TimothyHadfield/polar-cnc-plotter/chat.md

# Polar CNC Plotter: chat log (for Claude)

_One entry per session, newest at the bottom, capped at 60 KB. Older entries go to
`docs/archive/chat-archive.md`. The current state is in `progress.md`. Sessions before 2026-10-25
are only in git history and `docs/archive/progress-2026-10-27.md`._

## 2026-10-25..27 · build guide realism, carriage pocket, upgrade parts, motor debugging
- **Asked:** "make everything look like it does in real life" + tap-to-select; belt/idler fixes;
  better idler and platter-drive ideas; "change my pen holder carraige 3D print so it can have an
  indent nicely for the new wire stepper motor"; "make the arduino and shield V3 and motor drivers
  ... look nearly identical"; "send sub-agents to work on the other tasks"; troubleshooting.
- **Decided:** direct-drive platter + M3 idler recommended and built as STLs (Tim's go); red A4988
  on Z; binned 5 shorted drivers.
- **Built:** realistic build guide + tap card; X belt/idler model; carriage plate stage pocket
  (3fed47d); electronics model (9512a75); builders: platter_hub + motor_stand (ab39a36), motor_plate
  recess, pulley_m3, idler_washer, big_pulley_gt2, paper_ring (31ab319).
- **Verified how:** phone-view WebKit 393 px + 1440 px screenshots; OpenSCAD renders; trimesh
  watertight + measured sizes (GT2 OD 37.69 mm, 60 teeth); GRBL replies on COM3 (moves completed).
- **Machine:** dead/shorted drivers found by 5V-GND Ω (tripped USB fuse); coil pairs fixed on both
  NEMAs; X works; platter motor works on the X header; Y channel sends nothing; Z untested.
- **Open:** ask Tim whether the last test had X/Y drivers swapped; driver-vs-slot for Y (A-slot
  clone if the socket is dead); Z wiring; Calibrate; Tim to caliper the stage + shaft and check
  platter clearance; magnets vs tape for paper_ring (money = Tim).

## 2026-10-28 · motor troubleshooting, plotter being disassembled
- **Asked:** why the platter went jerky again; "Is anything ruined?" (pulled the Y plug powered);
  how to free the epoxied platter; "okay back to the troubleshooting".
- **Decided:** both NEMA plugs at 1-3-2-4; Y channel dead (carriage works on X, not on Y);
  platter jerk is electrical (spins freely by hand), suspect Tim's extension/plug; bench-test plan.
- **Built:** nothing (notes only).
- **Verified how:** Tim's meter and observations only; no COM port present today (USB unplugged).
  Tests not rerun (no code change since 10-27: 96/96).
- **Open:** Tim redesigned parts (unknown what) and is disassembling; bench test platter motor
  direct on X; driver-board swap X<->Y; Z; Calibrate.

## 2026-11-10..11 · bench debug to all three axes working
- **Asked:** "let's keep working on it" (motors before the full rebuild); for-sure driver test;
  which drivers to buy; returns.
- **Decided:** Tim drives the jogs, Claude advises; same Teyleten TMC2209 5-pack (Tim bought it).
- **Found:** Y and Z black drivers dead (one-variable swap in the proven X slot); most "jerky" =
  half-seated plugs/drivers or split coil pairs; new pen stage coils were 1-3 / 2-4 (middle swap
  fixed it, verified with Claude's Z jogs on COM3); platter plug middle wire loose.
- **Verified how:** Tim's observations + GRBL replies on COM3 (settings factory, Z jogs "ok").
- **Open:** rebuild; `$102` for the stage; Calibrate; Claude's earlier "smallest step" advice was
  wrong (0.1 mm jog ≈ invisible with factory `$102`).

## 2026-11-12 · fasteners, no fit test, then a full engineering review
- **Asked:** which screws/nuts and where to buy (Ace, Orem); use his M3 × 8 pan heads on the
  collar; "I'm not gonna do a test print"; after switching model: "let's do all of that. I have the
  base plate design actively printing right now but that's it."
- **Decided:** base untouched (printing); stands, wheel, collar free to change; fit test dropped
  from plate 1; printed washers instead of buying M3 × 6.
- **Built:** stand groove relief + foot clearance, steeper collar taper, collar gauge, motor
  washers, wheel 2 mm over the cage (lift +1), guide wording fixes (stands from the back, supports
  setting, gauge, 1.0 V, GRBL speeds), sim travel 93, plotter-v2.glb rebuilt, plates 1/3/4.
- **Verified how:** OpenSCAD intersections (seated, sliding in, stop, lift, travel 93/94, screw
  sweep, spinning envelope vs everything fixed: all as expected); headless Bambu Studio slices of
  all 5 plates with Tim's X1C presets; 101/101 node tests; phone-view 393 px + 1440 px of
  build.html?v=2 and sim.html?v=2 on localhost.
- **Open:** pen clip for the new slider needs Tim's measurements; nothing printed from the changed
  parts yet. Base supports: Tim "did add supports"; Bambu's default leaves "On build plate only"
  unticked (stock preset checked, no user preset), so the cage roof should be supported.

## 2026-11-12 (later) · Draw tool
- **Asked:** "for the plotter app, could you make a feature where you can draw your own design
  yourself on the plate as a submission for the drawing?"
- **Decided (Claude, flagged to Tim):** a Draw button beside Text/Pattern, same tool-panel pattern;
  drawing lands exactly where drawn (no auto-fit); Undo also undoes Clear; kept across reloads.
- **Built:** `js/sketch.js`, `strokes.radius` in `fitFrame`, `layout()` split out of `prepare`,
  place.js steps aside while drawing, `tests/sketch.test.mjs` (10 tests).
- **Verified how:** tests seen failing first (stretch-to-fit, no smoothing), then 111/111; headless
  WebKit at 393 px and 1440 px: drew a face with mouse drags + taps, start point within 1 px of the
  pointer, undo/clear/undo, Done -> "4 strokes", move 20 mm then Draw again (stays put), touch tap,
  reload keeps it; no console errors, no page scroll.
- **Open:** Tim's finger on his iPhone; laptop button row wraps.

## 2026-11-13 · Simulate the drawing
- **Asked:** "allow the user to simulate the drawing aswell."
- **Found:** the Draw commit had broken sim.html (app.js runs there too; no `#openDraw` ->
  exception at start-up, seen live with phone-view). Fixed in the same change (see Traps).
- **Decided (Claude, flagged to Tim):** read as "watch the 3D plotter draw what I made": a Simulate
  link beside Download G-code that carries the drawing over; Draw tool also inside the simulator;
  opens V2.
- **Built:** `js/handoff.js` + `tests/handoff.test.mjs` (4 tests, seen failing with the extras
  dropped), Simulate link, Draw button/panel in sim.html, inset grows while drawing.
- **Verified how:** 115/115 tests; headless WebKit 393 px + 1440 px, local then live: sim.html
  v=1/v=2 load with no exceptions; draw face -> Done -> move -> Simulate -> same "4 strokes" in the
  simulator -> Connect -> Plot at 100× -> "Done in 1 min." -> Draw there adds a 5th stroke.
- **Open:** Tim's own try; on the phone the simulator's small plan shows Crop/Reset overlapping
  (older layout, not touched).

## 2026-11-13 (later) · collar onto the clamp-ring plate
- **Asked:** "put that necessary connector in the last plate and clamp ring print so I can easily
  skip the test print and still have all the necessary parts."
- **Decided (Claude, flagged to Tim):** moved everything from plate 1 (collar, gauge, washers), not
  only the collar, since the gauge and washers are needed too; plate 1 removed; file renamed
  `plate5_clamp_ring_and_small_parts.3mf`; plate numbers kept.
- **Verified how:** meshes compared with the committed plate 1/5 (identical); gaps on a 0.5 mm
  grid; headless Bambu Studio slice with Tim's X1C presets (33 min, 18 g, 0 supports).
- **Open:** nothing printed from it yet.
- **Brim question:** the message Tim saw is a rotating Bambu tip (hints.ini), not a warning; his
  preset is brim Auto and the slice made no brim. Nothing changed.
- **ABS question:** out of PLA; answered yes and added an ABS version of plate 5 (ring 100.4 % in
  X/Y, reasoned). Sliced headless with Bambu ABS on Textured PEI. Open: whether Tim's wheel is PLA
  (assumed), and how the hooks actually fit.

## 2026-11-13 (evening) · first assembly report
- **Asked:** printed everything but plate 5; pen ~1 inch behind the platter motor; Uno pads block
  the board's bottom pins; one base rail printed rough. "Don't change anything yet, I'll talk about
  specific dimensions in a bit."
- **Decided:** nothing built. Agreed with his fix (reprint the base, cage moved toward the rods);
  cause = the never-measured `carriage_d`. Details in progress.md (11-13 block).
- **Open:** his dimensions; a photo of the rough rail; his other base problems.

## 2026-11-13 (night) · base 2 and the stage model
- **Asked:** his diagnosis: the model's linear stage is "a large brick that pushes the pen and pen
  holder out quite a lot"; the real slider "only sticks out about 1 cm further than the rest of the
  motor". "Try to redesign both the model and the base plate so that it fixes these problems I
  stated." Mid-work: "how close are you to finishing"; "pull up the build guide artifact again"
  (opened the checklist artifact; said which reading was taken).
- **Decided (Claude, flagged to Tim):** platter motor adjustable +-10 mm front to back instead of a
  fixed stop (his inch = 25 mm vs the corrected chain's 14 mm; pen holder not final); cage centre
  20 mm back; roof kept whole (shaft slot + boss channel); rail left alone; extra file
  `plate2_base_only.3mf`.
- **Built:** stage/slider model, `pen_y` 3.0, new `motor_cage()`, pads loop removed, frame_base.stl,
  both GLBs, plate 2 files, sim centres, wire routes, guide step, checklist artifact.
- **Verified how:** OpenSCAD intersections (motor at both ends, sliding in, over-travel hits the
  ribs, spinning envelope, carriage), watertight STL, headless Bambu slice (3 h 2, 150 g, supports
  only under the cage roof), GLB centres measured at y 3.00, 115/115 tests, headless WebKit 393 px
  + 1440 px of build.html and sim.html (v1 + v2), no exceptions.
- **Open:** the print itself; his "other problems"; the rail photo; pen clip for the new slider.

## 2026-11-13 (late) · calibration by Stop button, pen holder, cutting circles
- **Asked:** "I have the entire thing built perfectly and I'm ready to start working on the
  calibration. Could you make the calibration system more intuitive? For example, have the plate
  move slowly in a circle until the user says stop at 360 degrees ... Or have the linear motor
  slowly move down until the user clicks stop ... For the X axis maybe Calibrate it so that it
  knows where the edges of the plate are, and then it can calculate where the center is itself?"
  Also: the missing pen-holder piece ("the longer flat part with round holders on the end"), and
  "a pdf that has circles on it with the same size as the plate" for the paper and the rubber.
  Earlier: what the printed bar with an indent is (the collar gauge).
- **Decided (Claude, flagged to Tim):** the pen cannot reach both plate edges (93 mm one side, 78
  the other), so the center comes from a circle the pen draws and then crosses; that circle,
  measured with a ruler, also gives `$100` (the old 20 mm rail test is gone). Slow speeds are set in
  motor steps per second. `$101` rounds to the exact direct-drive value within 2 %. Pen heights are
  saved as up 0 / down -lift with `G92 Z0` at the up height. Holder neck narrowed 18 -> 13.6 mm so
  his printed clip (14 mm opening) goes over it. Paper circle 196 mm, pad 200 mm.
- **Built:** `js/calibrate.js` rewritten (steps 2-5), `grbl.penZero` + `setPenZero()` + Z restored
  after Stop, the pretend GRBLs count steps (`rescale`, `SimGrbl.real()`), 5 new tests;
  `pen_holder()` + `build/stl/pen_holder.stl` + `build/print/plate6_pen_holder.3mf`;
  `tools/make-circles-pdf.py` + `build/print/paper_and_pad_circles.pdf`.
- **Verified how:** node tests 120/120, each new one seen failing against a one-line mutation;
  headless WebKit of sim.html?v=2 driving every step; OpenSCAD intersection clip-over-neck = 0 mm³
  (120 mm³ on the original 18 mm neck); headless Bambu slice 8 min / 3.8 g; PDF sizes read back
  from the file (196.0 / 200.0 mm, scale line 100.0 mm).
- **Open:** nothing run on the real plotter. Pen holder not in the 3D model or guide.

## 2026-11-13 (night) · a wrong `$101` made the platter scream; safeguards
- **Asked:** "I did the proceedure where it says go and then you count how many full rotations it
  did, and i counted 56 full rotations, and then when I clicked save and did it again, it
  completely freaked out and sounded like it tried to spin at an extreamly fast speed. I'm afraid I
  broke the motor ... when I did the slow turn thing that we discussed it doesn't even move and
  just kinda jiggles back and forth while still. When I jog the motor individually, it sounds like
  it tries to spin at an incredibly fast speed again. Do you know what's happening? Is the motor
  fine? Can we set up safeguards on our cite which make it so that problems like these are
  impossible?"
- **Decided (Claude):** cause = 56 (turns) typed where the old step wanted degrees -> `$101` 1607
  instead of ~4.444 (reasoned, COM3 was in use so `$$` was not read). A stalled stepper is not
  damaged. Guards go in the app, not in advice: range check on connect and on save, step-rate caps,
  Stop on every long Calibrate move, self-reset of absurd values.
- **Built:** `js/safe.js`; `machine.js` reads `$$` (connect, console setting, Calibrate save) and
  switches off the bad axis' jogs + Plot with a red line; `calibrate.js` refuses out-of-range
  saves, caps nudges in steps/s, resets values above 5000, Stop for circle / set center / test
  drawings; `tests/safe.test.mjs` (7 tests, Tim's 56 as the fixture).
- **Verified how:** node tests 127/127; six one-line mutations each failed a new test; Playwright
  WebKit on local `sim.html?v=2` at 393 px and 1440 px, 16 checks each (warning text, jogs and Plot
  off, turn test from 1607 on a 4.444 platter -> 4.444 saved, calculator value 888.889 refused,
  circle stopped at 18-19°, pen up, 578571 reset to 8.889), no exceptions; `index.html?demo` and
  `sim.html?v=1` load clean.
- **Open:** Tim to hard-refresh, read `$101` in Calibrate step 1, run the Turn test. If the platter
  still jiggles at a sane value: reseat the platter plug and driver (12 V and USB out).

## 2026-11-14 · Calibrate reworked after Tim's first run; auto-connect
- **Asked:** "I'm not really sure what the first step is but it's not necessary. For step 2, allow
  the user to "test" it which means to have it rotate in what it thinks is a full circle. If it's
  not in a full circle, the user will either click the forward or back button to show where the
  true full circle mark is, or they will redo step 2. For the linear motor, any time the cite says
  "down", the motor goes up, and vice versa, so I think we put it upside down (which is the way
  that I want it), so reverse the directions on the cite. For step 3, instead of the slow movement,
  just have the user click down or up to mark exactly where the pen is touching the plate ... move
  it up a little bit off that and then put it back down to draw. For step 4, I'm not really sure
  what's happening but It sounds like you need to make the instructions more clear. Step 4 should
  be a carraige motor calibration though." Mid-turn: "if you click connect and there's only one
  option to connect to, it automatically connects to that connection?"
- **Decided (Claude, flagged to Tim):** his "step 4" read as: a carriage step of its own (Draw line
  + ruler -> `$100`), with Find center after it and its instructions numbered. Pen direction is
  written into the plotter (`$3` bit 2) on connect, so Down is down everywhere, with a "Reverse
  direction" switch in Pen height in case it is still backwards. Touching lifts 100 motor steps.
  After Test the new `$101` is not rounded to a "nice" value. "Rail" -> "Carriage" in warnings.
  Auto-connect only when exactly one port is already remembered; a port that fails to open makes
  the next Connect show the list.
- **Built:** `js/calibrate.js` rewritten (Turn test + Test, Pen height, Carriage test, Find center,
  Center gap, Mirror check; the settings step and calculator are gone), `zFlip` setting + `$3` on
  connect in `machine.js`, `pickPort` in `grbl.js`, `tools/check-calibrate.mjs`,
  `tools/check-connect.mjs`; old CALIBRATE 2 notes and the 11-10/11 debug log moved to
  `docs/archive/progress-2026-11-14-calibrate2-and-driver-debug.md`.
- **Verified how:** node tests 131/131; 8 one-line mutations of calibrate.js and 1 of `pickPort`
  each failed a test; Playwright WebKit on `sim.html?v=2`, 35 checks at 1440 px and at 393 px (a
  platter needing 4.444 at factory 250 -> Turn slowly -> 4.444 -> Test lands on 360°; one needing
  4.5 -> Test stops 4.5° short -> Further -> 4.500; `$3` 0 -> 4 and old heights 0/1.5 -> 0/-1.5;
  Down/Up/Touching -> up 0 / down -1; line 50 mm -> `$100=40.000`; circle/cross/Set center), no
  page errors, no page scroll; connect check 5/5 with a stand-in `navigator.serial`.
- **Open:** nothing of this has run on the real plotter (see NOT verified). Speed step if the
  platter turns slowly. Mistake to avoid: `git checkout -- file` after a mutation test also throws
  away uncommitted work in that file; reverse the edit instead.
- **Later, asked:** "make the carraight motor say left and right, not in and out." Built: Left
  (X+, away from the center) / Right (X-) on the main panel and in Calibrate, instructions reworded
  ("Jog the pen left, near the platter edge."). Verified: 131/131 tests; headless WebKit on
  `sim.html?v=2`, 35/35 at 393 px and 1440 px; Left raised X 0 -> 4, Right lowered it to 2.
- **Later still, asked:** "for the calibration, there shouldn't be any proceedures that require you
  to draw on the paper, because it's hard to get the paper and It needs to be as easy as possible."
  **Decided (Claude, flagged to Tim):** 5 steps, nothing draws. Mirror check -> "Turn direction"
  (quarter turn, Clockwise / Counterclockwise sets Reverse rotation); Carriage test = a pen-up
  Move over a ruler, `$100` rounded to an exact belt value within 2 %; Find center = a mark under
  the tip, Half turn, the mark again -> center halfway + center gap worked out and saved (the
  separate Center gap step is gone). Pen height still needs the tip to touch once. **Built:**
  `js/calibrate.js` (`snapBelt`, `beltSteps`, `gapFromMark`, `partTurn`; `drawCircle`,
  `centerLine`, `letterF`, `offsetFromGap` removed), tests, `tools/check-calibrate.mjs`; the old
  steps' notes in `docs/archive/progress-2026-11-14-calibrate3-drawing-steps.md`. **Verified
  how:** 132/132 node tests; 6 mutations each failed a test; headless WebKit on `sim.html?v=2`,
  41/41 at 393 px and 1440 px (true gap 0.7 mm found as 0.7; no "draw" or "paper" text anywhere in
  the tool). **Open:** not run on the real plotter; lining a mark up by eye limits the gap to
  about ±0.3 mm (reasoned).
- **Then (real plotter):** "I calibrated it so that It goes around the circle once and then I
  stopped it, but then when I tested it, it did 2 full rotations rather than just 1." Cause: Test
  used the value still in the plotter; the new one was not saved. Fix: Test saves the New `$101`
  first. Verified: the simulator walk turned 720° before the fix, 360° after (check 36, 42/42 at
  393 px and 1440 px), 132/132 node tests. Also told Tim calibration is once (stored in GRBL +
  this browser) except Set center at every connect.
