TimothyHadfield/polar-cnc-plotter/build/print/paper_and_pad_circles.pdf

## Paper circle: 196 mm

Print at 100 % ("Actual size"), not "Fit to page". Cut on the line.

This line is 100 mm. Check it with a ruler before cutting.

## Soft pad circle: 200 mm (same as the platter)

Print at 100 % ("Actual size"), not "Fit to page". Cut on the line.

This line is 100 mm. Check it with a ruler before cutting.
