TimothyHadfield/polar-cnc-plotter/samples/hello-block.png

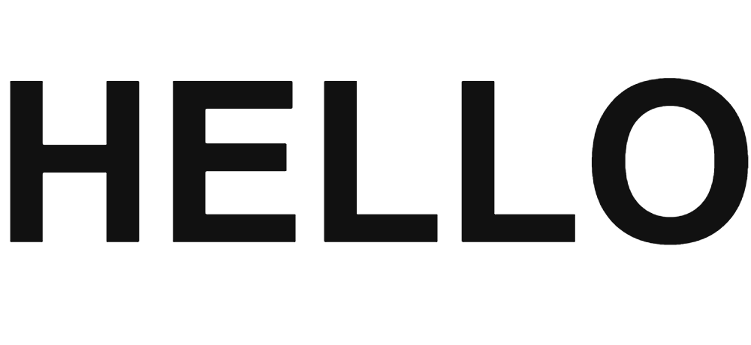
samples/hello-block.png
