TimothyHadfield/polar-cnc-plotter/build/print/plate6_pen_holder.3mf

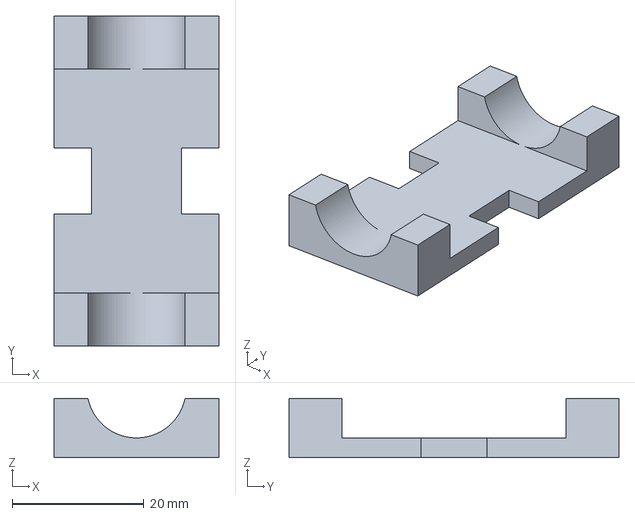
[picture p9: CAD file, 2026-11-14]
build/print/plate6_pen_holder.3mf
25.0 x 50.0 x 9.00 mm
