TimothyHadfield/polar-cnc-plotter/build/print/plate2_base_and_small_parts.3mf

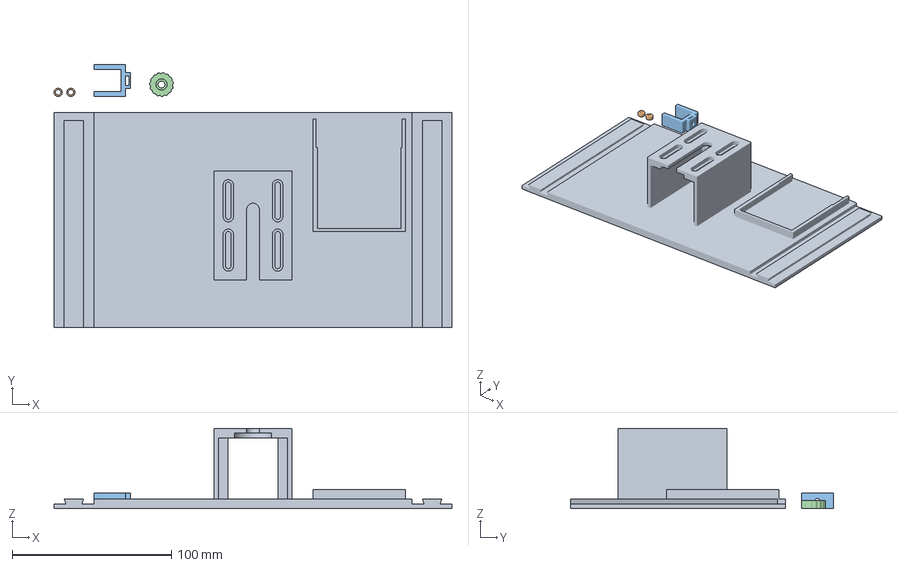
[picture p10: CAD file, 2026-11-13]
build/print/plate2_base_and_small_parts.3mf
250.0 x 165.0 x 50.5 mm
base
idler_spacers
pen_clip
pen_knob
