TimothyHadfield/polar-cnc-plotter/build/stl/frame_base.stl

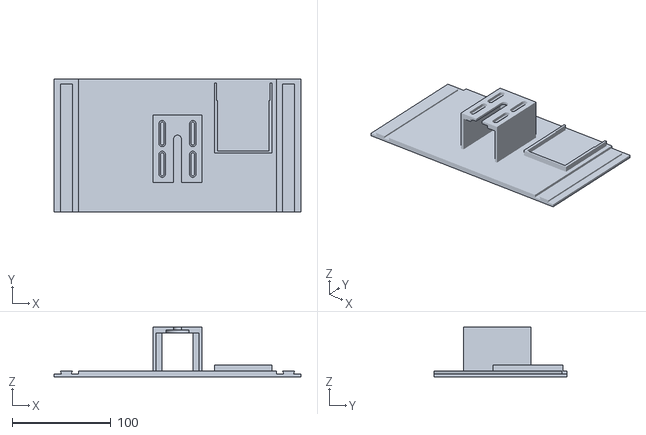
[picture p11: CAD file, 2026-11-13]
build/stl/frame_base.stl
250.0 x 135.0 x 50.5
