TimothyHadfield/polar-cnc-plotter/build/stl/frame_stand_left.stl

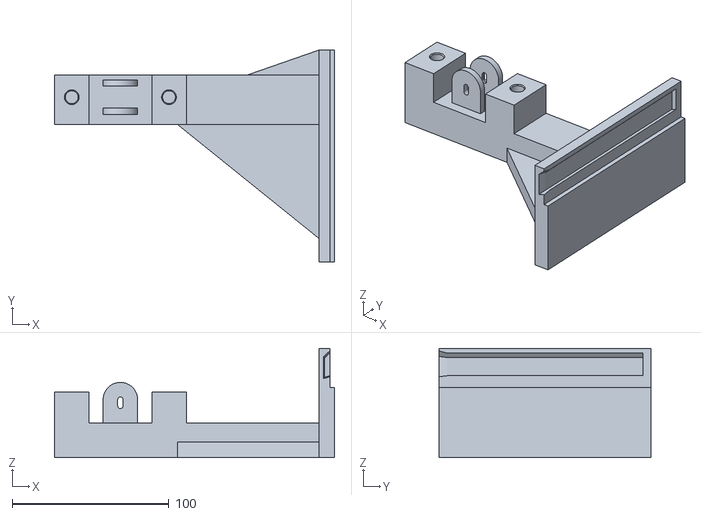
[picture p12: CAD file, 2026-11-12]
build/stl/frame_stand_left.stl
178.5 x 135.0 x 69.7
