TimothyHadfield/polar-cnc-plotter/build/print/plate5_clamp_ring_and_small_parts_ABS.3mf

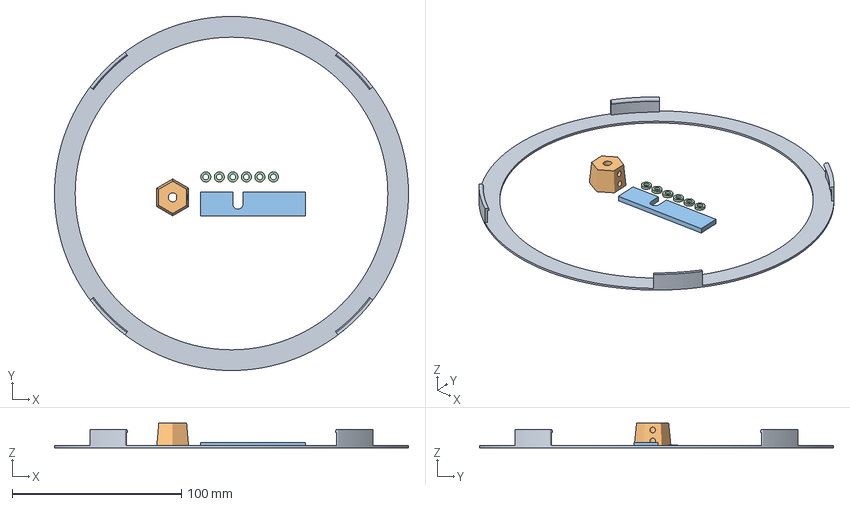
[picture p13: CAD file, 2026-11-13]
build/print/plate5_clamp_ring_and_small_parts_ABS.3mf
209.2 x 209.2 x 14.5 mm
clamp_ring_ABS
shaft_collar
collar_gauge
motor_washers
