TimothyHadfield/polar-cnc-plotter/build/stl/frame_wheel.stl

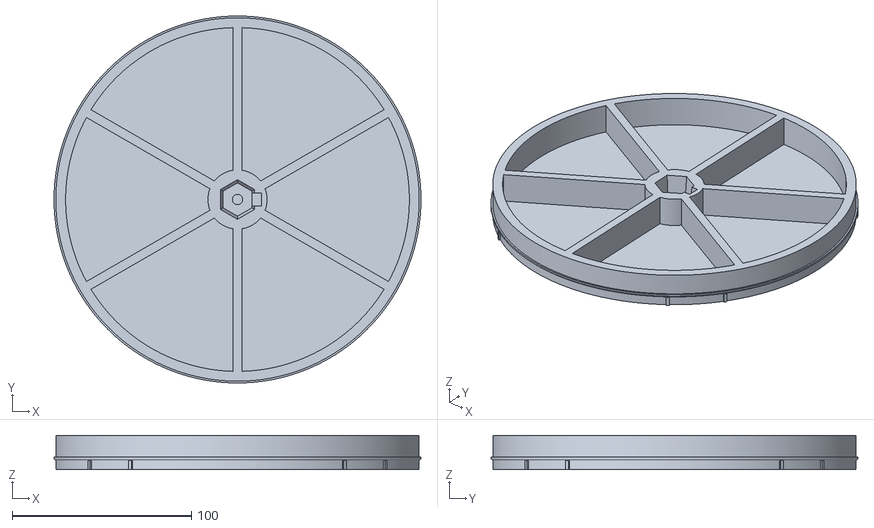
[picture p14: CAD file, 2026-11-12]
build/stl/frame_wheel.stl
205.0 x 205.0 x 19.0
