TimothyHadfield/polar-cnc-plotter/build/stl/frame_collar.stl

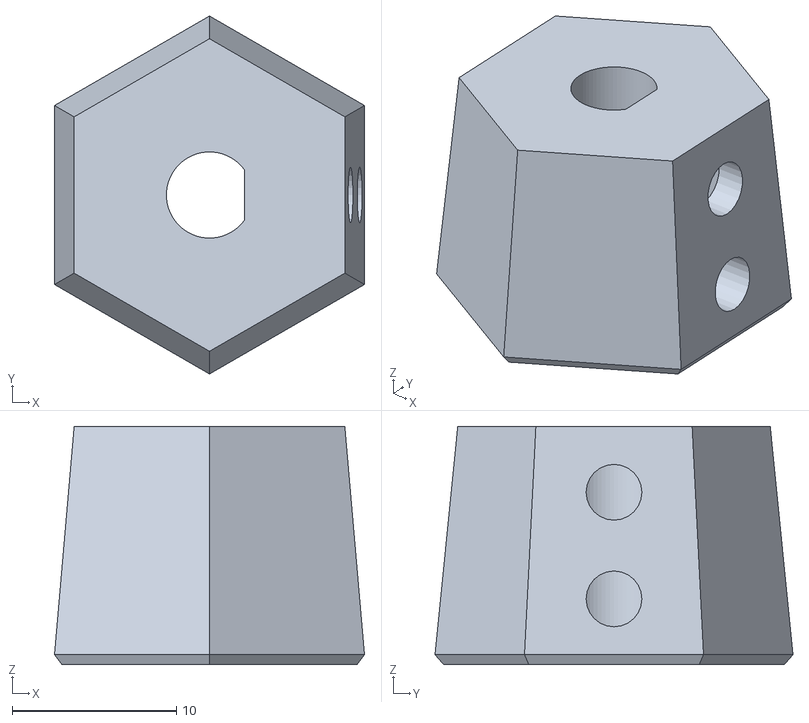
[picture p15: CAD file, 2026-11-12]
build/stl/frame_collar.stl
18.9 x 21.8 x 14.5
