TimothyHadfield/polar-cnc-plotter/build/stl/frame_stand_right.stl

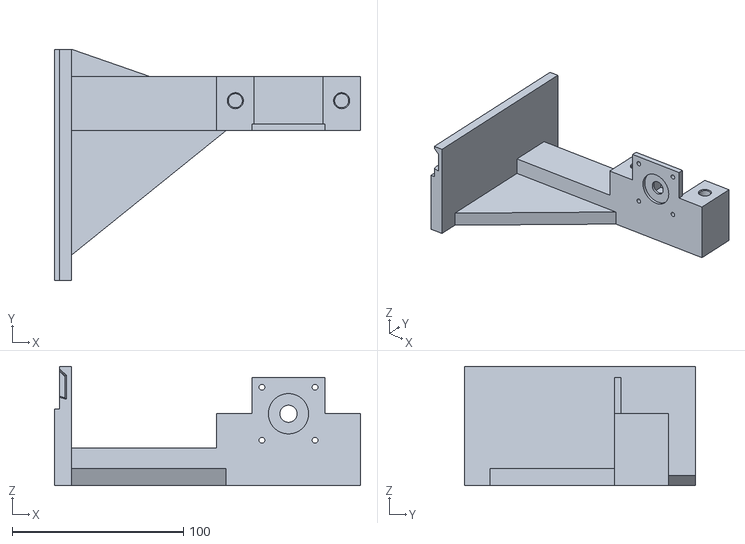
[picture p16: CAD file, 2026-11-12]
build/stl/frame_stand_right.stl
178.5 x 135.0 x 69.7
