TimothyHadfield/polar-cnc-plotter/build/stl/frame_fit_test.stl

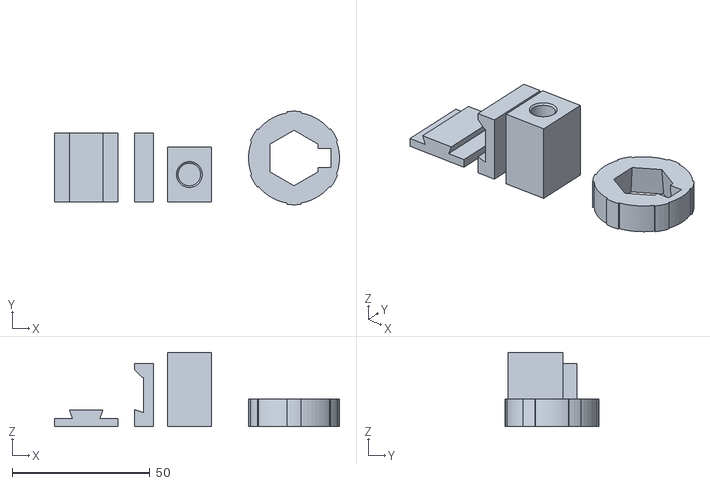
[picture p17: CAD file, 2026-11-12]
build/stl/frame_fit_test.stl
103.5 x 34.0 x 27.0
