TimothyHadfield/polar-cnc-plotter/build/print/plate3_stands.3mf

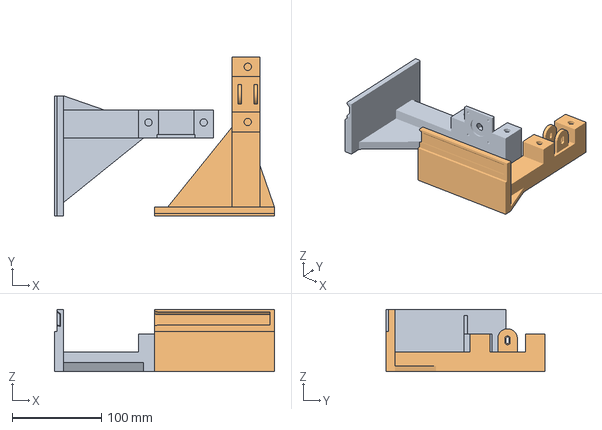
[picture p18: CAD file, 2026-11-12]
build/print/plate3_stands.3mf
247.0 x 178.5 x 69.7 mm
stand_right
stand_left
