TimothyHadfield/polar-cnc-plotter/build/print/plate5_clamp_ring.3mf

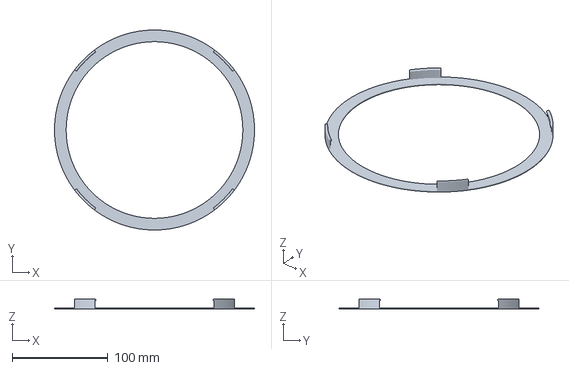
[picture p19: CAD file, 2026-11-12]
build/print/plate5_clamp_ring.3mf
208.4 x 208.4 x 10.7 mm
