TimothyHadfield/polar-cnc-plotter/build/stl/frame_collar_gauge.stl

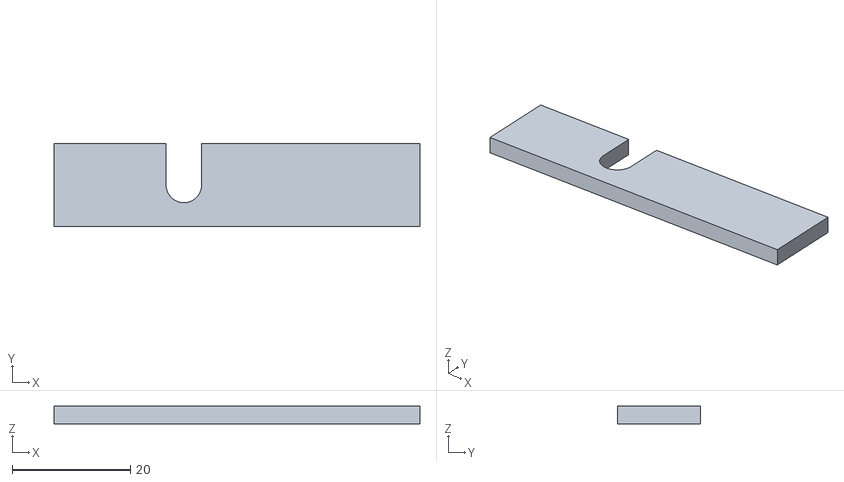
[picture p20: CAD file, 2026-11-12]
build/stl/frame_collar_gauge.stl
62.0 x 14.0 x 3.00
