TimothyHadfield/polar-cnc-plotter/build/print/plate1_fit_test_and_collar.3mf

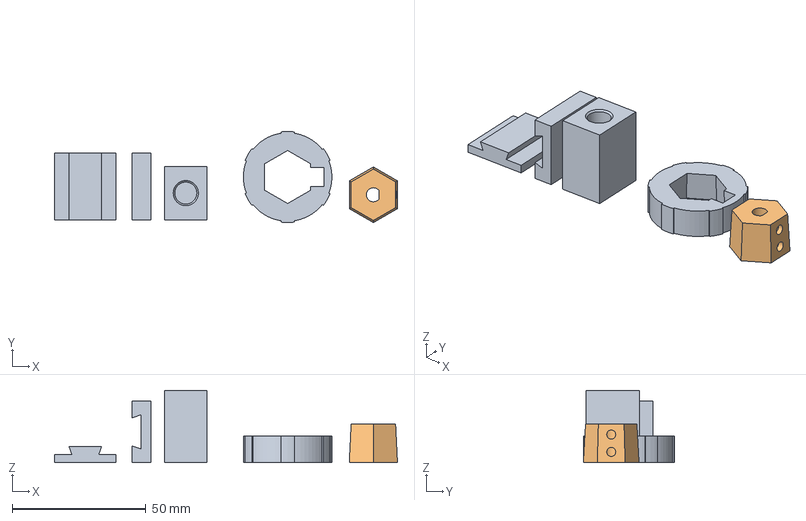
[picture p21: CAD file, 2026-11-12]
build/print/plate1_fit_test_and_collar.3mf
128.0 x 34.1 x 27.0 mm
fit_test
shaft_collar
