TimothyHadfield/polar-cnc-plotter/build/stl/frame_idler_spacers.stl

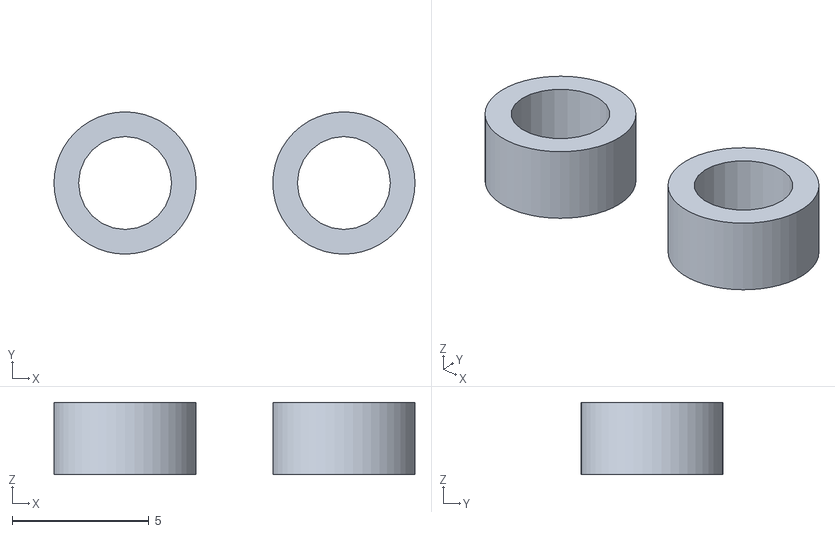
[picture p22: CAD file, 2026-11-12]
build/stl/frame_idler_spacers.stl
13.2 x 5.20 x 2.65
