TimothyHadfield/polar-cnc-plotter/build/stl/spool.stl

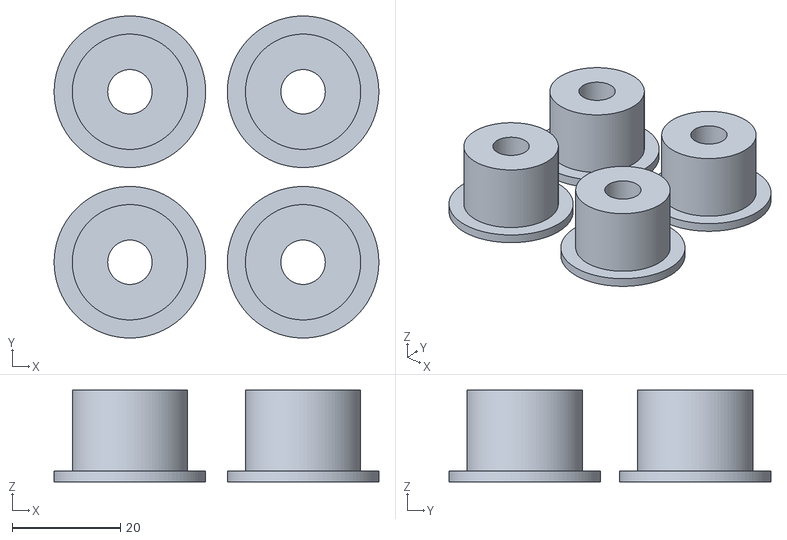
[picture p23: CAD file, 2026-11-12]
build/stl/spool.stl
60.0 x 59.5 x 17.0
