TimothyHadfield/polar-cnc-plotter/build/stl/rod_gauge.stl

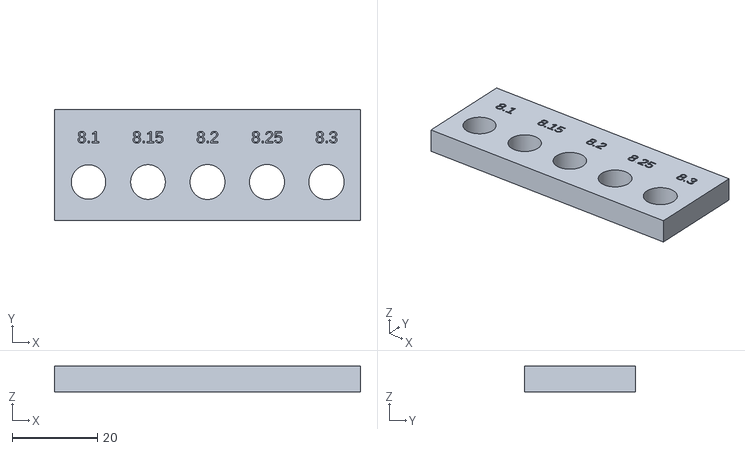
[picture p24: CAD file, 2026-11-12]
build/stl/rod_gauge.stl
72.0 x 26.0 x 6.00
