TimothyHadfield/polar-cnc-plotter/build/stl/pulley_m3.stl

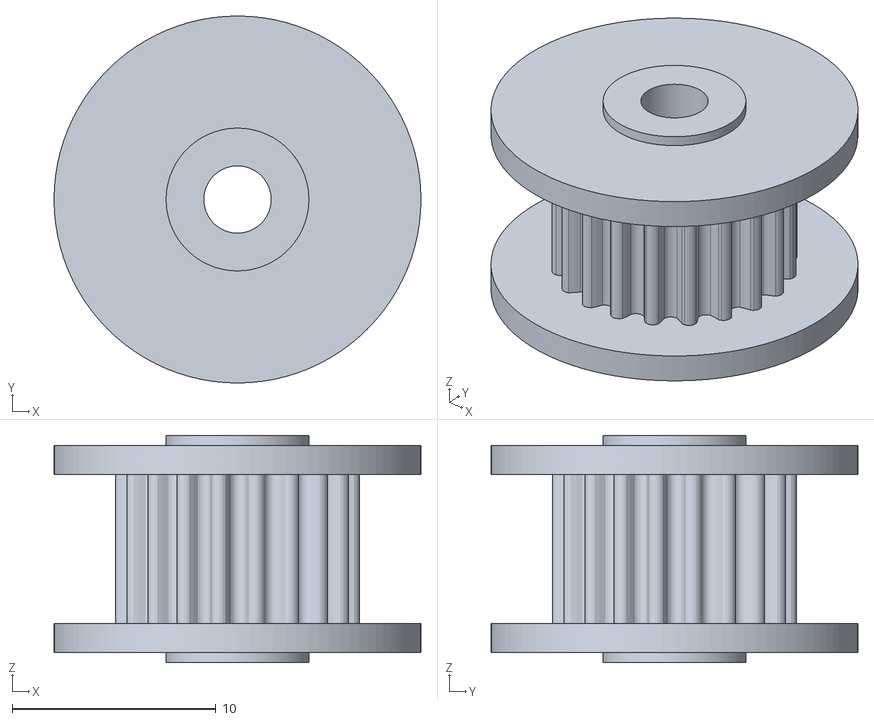
[picture p25: CAD file, 2026-10-26]
build/stl/pulley_m3.stl
18.0 x 18.0 x 11.1
