TimothyHadfield/polar-cnc-plotter/build/stl/paper_ring.stl

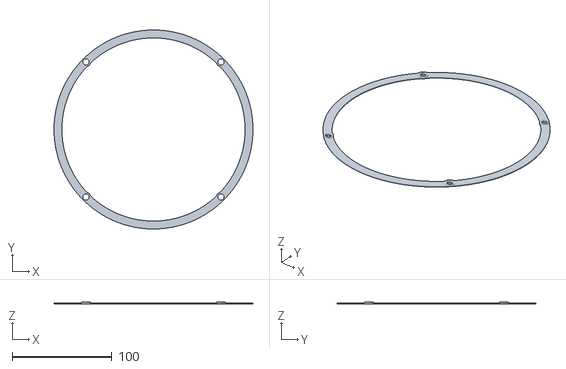
[picture p26: CAD file, 2026-10-26]
build/stl/paper_ring.stl
200.0 x 200.0 x 2.00
