TimothyHadfield/polar-cnc-plotter/build/stl/carriage_plate.stl

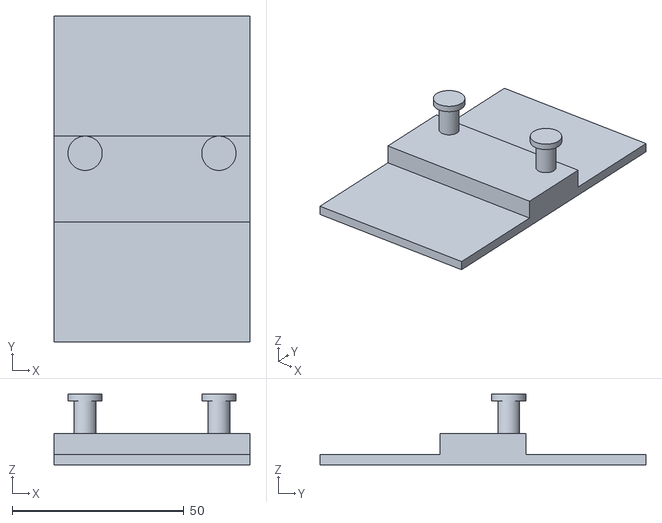
[picture p27: CAD file, 2026-10-26]
build/stl/carriage_plate.stl
57.0 x 95.0 x 20.7
