TimothyHadfield/polar-cnc-plotter/build/stl/pulley_a.stl

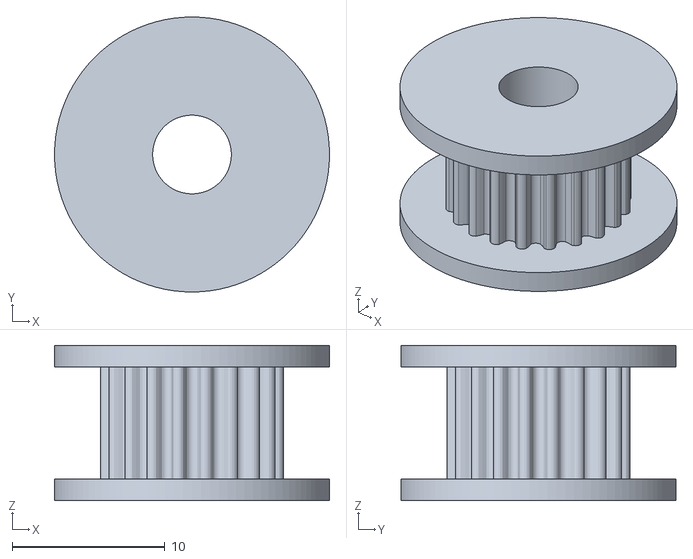
[picture p28: CAD file, 2026-10-25]
build/stl/pulley_a.stl
18.0 x 18.0 x 10.1
