TimothyHadfield/polar-cnc-plotter/build/stl/bracket.stl

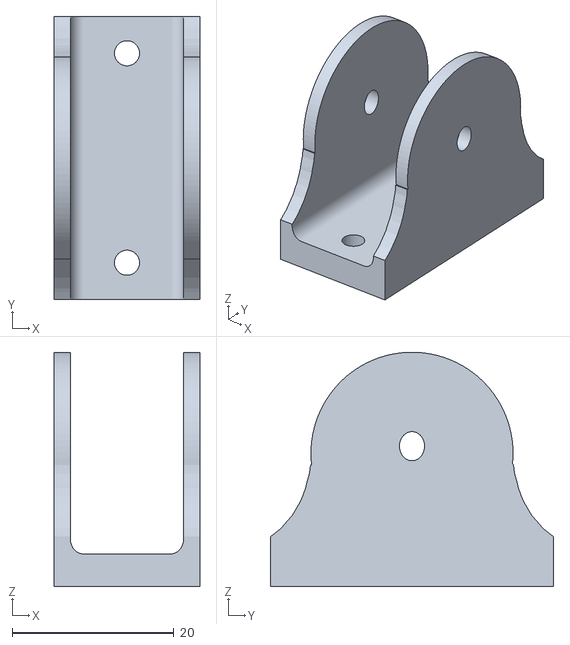
[picture p29: CAD file, 2026-10-25]
build/stl/bracket.stl
18.0 x 35.0 x 29.0
