TimothyHadfield/polar-cnc-plotter/build/stl/clip.stl

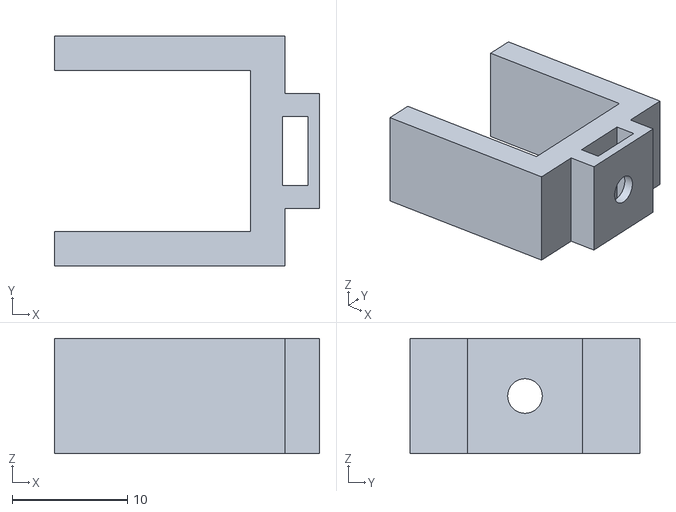
[picture p30: CAD file, 2026-10-25]
build/stl/clip.stl
23.0 x 20.0 x 10.0
