TimothyHadfield/polar-cnc-plotter/build/stl/motor_plate.stl

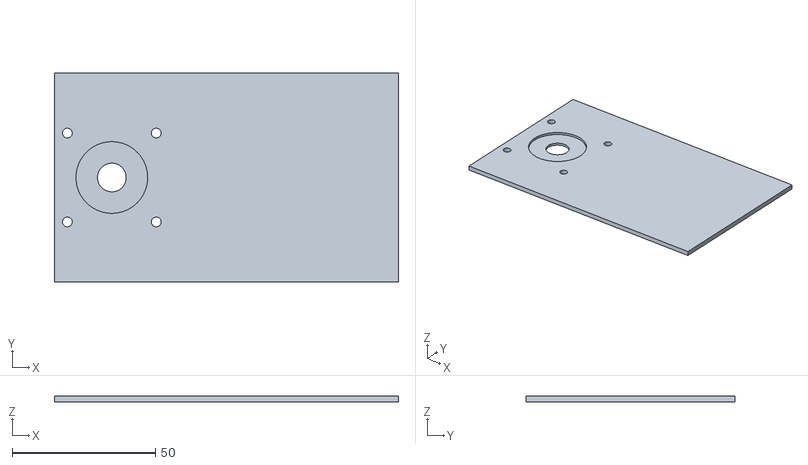
[picture p31: CAD file, 2026-10-25]
build/stl/motor_plate.stl
120.0 x 73.0 x 2.00
