TimothyHadfield/polar-cnc-plotter/build/stl/gear.stl

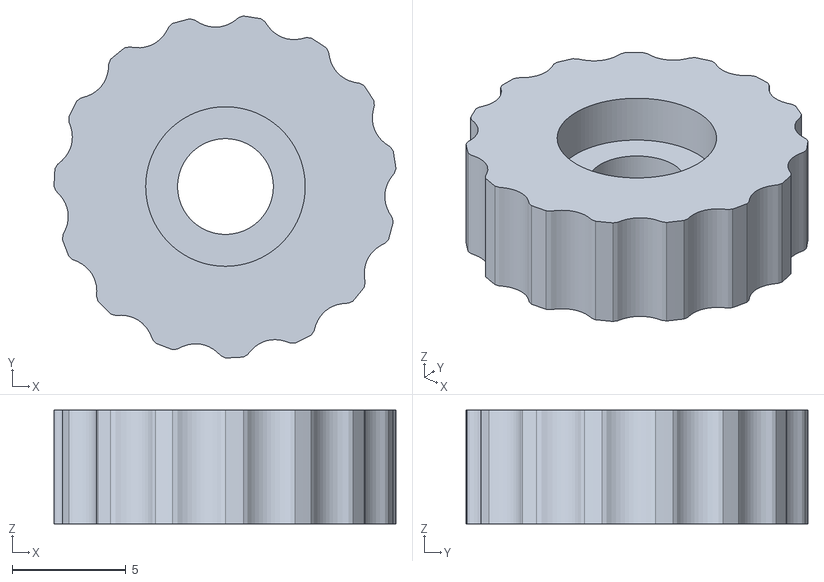
[picture p32: CAD file, 2026-10-25]
build/stl/gear.stl
15.0 x 15.0 x 5.00
