TimothyHadfield/polar-cnc-plotter/build/stl/big_pulley.stl

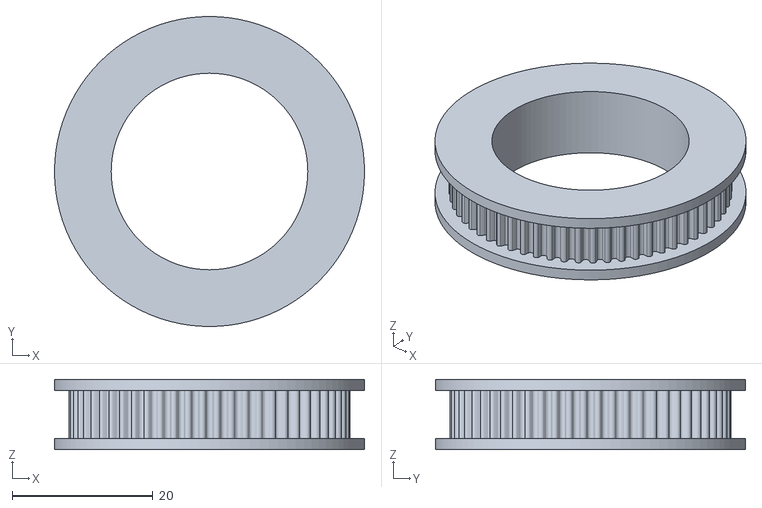
[picture p33: CAD file, 2026-10-25]
build/stl/big_pulley.stl
44.0 x 44.0 x 10.0
