TimothyHadfield/polar-cnc-plotter/build/stl/motor_plate_2.stl

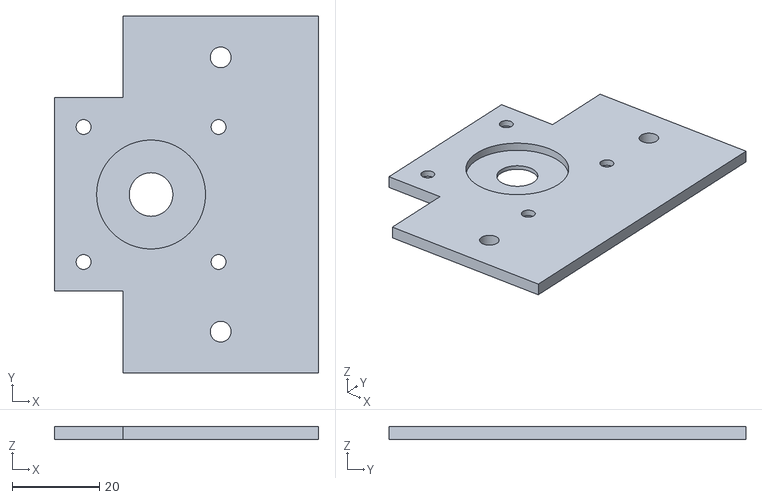
[picture p34: CAD file, 2026-10-25]
build/stl/motor_plate_2.stl
60.7 x 82.0 x 3.00
