TimothyHadfield/polar-cnc-plotter/(list of files, cad)

Other CAD files:
build/stl/pen_holder.stl
build/print/plate2_base_only.3mf
build/print/plate5_clamp_ring_and_small_parts.3mf
build/print/plate4_wheel.3mf
build/stl/frame_clamp_ring.stl
build/stl/pulley_b.stl
build/print/plate1_collar_gauge_and_washers.3mf
build/stl/frame_motor_washers.stl
build/stl/idler_washer.stl
