TimothyHadfield/polar-cnc-plotter/(commit log)

2026-09-28 Plotter app phase 1: SVG to polar G-code with preview
    Own Cartesian-to-polar converter replacing GRBL-Plotter's, whose angle
    unwrap goes by the sign of the angle and spins the platter a full turn
    with the pen down. Short-way unwrapping, adaptive segmentation to 0.1 mm,
    center-gap correction, G93 steady pen speed, preview drawn from the
    output G-code. 26 tests simulate GRBL's moves; Phase 0 machine test files.
2026-09-28 Picture upload: trace PNG/JPG into pen lines
    Outlines by default, centerlines switch in Settings, Darkness slider,
    paste (Ctrl+V) and drag-drop of pictures. Tests for the tracer.
2026-09-29 Plot button: drive the plotter over USB (Web Serial)
    Connect, jog, pen up/down, set center, Plot/Pause/Stop with progress,
    live pen position on the preview, GRBL console in Settings.
    Character-counting streaming; tested against a simulated GRBL (?demo).
2026-09-30 Move, Turn, Crop: drag the drawing, turn slider, crop box on the preview
    - polar.js: prepare(raw, opts, place) crops (raw bbox-normalized rect), fits,
    turns (+ = counter-clockwise), moves, then clips to the drawing circle
    (clipOuter splits strokes on the edge). Identity placement = old output.
    - place.js: pointer drag to move (rAF-throttled; heavy drawings preview by
    shifting the simulated ink, rebuild on release), Crop/Reset buttons, crop
    box overlay; a turned box crops to its bounding box in raw space.
    - Size row is now Size + Turn half-width sliders. Placement resets per drawing.
    - tests/place.test.mjs: 8 tests, each seen failing under a mutation.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
2026-09-30 Picture styles: Spiral and Hatch, plus Line gap setting
    Settings: the Centerlines switch becomes a Picture style picker
    (Outlines, Centerlines, Spiral, Hatch); old center:true migrates.
    New Line gap field (mm on paper). Spiral is one stroke wiggling where
    dark; Hatch is up to three line directions by darkness. Both keep the
    gap true in mm after fitting and re-trace when size or gap changes.
2026-09-30 Calibrate tool: guided $100/$101, pen heights, center gap and mirror check
    Six-step tool panel opened from a Calibrate link next to Disconnect.
    Reads $$ (new Grbl.readSettings), works out steps from the parts,
    turn/rail tests with corrected values, pen height jog + save, center
    line test for the gap, and an F for the rotation direction.
    FakeGrbl now remembers $n= values and echoes them in $$.
2026-09-30 Plot extras: progress shading, resume after a stop, pen changes for multi-colour SVGs
    - simulate() tags drawn points with their G-code line; the preview shows
    not-yet-drawn ink light during a plot (estimate lags GRBL's 15-block planner)
    - a plot that ends early can pick up with 'Resume NN%' (pen-up move back,
    5-line overlap, never back across a pen change)
    - SVG stroke colours become pen groups: M0 pause between groups, preview in
    each pen's colour, 'Change to pen 2' message; FakeGrbl supports M0
    - tests/plot-extras.test.mjs: 9 tests
2026-10-16 Accessibility: labels on console and calibrate inputs; blank favicon stops a 404
2026-10-24 progress: motors don't move; GRBL checked over COM3, suspect 0.5 A supply
2026-10-24 progress: drivers are TMC2209 and were plugged in rotated 180 degrees
2026-10-24 progress: end of motor debugging session, next steps for coil wiring
2026-10-25 cad: motor plate as an OpenSCAD part (redrawn from the TinkerCad STL, M3 holes 3.4)
2026-10-25 cad: all TinkerCad plate parts as OpenSCAD modules (replaces motor-plate.scad)
2026-10-25 docs: components reference (all parts, jobs, GT2 pitch finding, open questions)
2026-10-25 docs: components from Tim's Amazon list (16T X pulley, motor specs, belts, rods, discs)
2026-10-25 docs: Tim's build review notes and old GRBL settings in components reference
2026-10-25 docs: Tim's explanation of each printed part, new linear-stage Z motor
2026-10-25 docs: how the plotter is assembled (from the guide's step photos)
2026-10-25 3D build guide page: step-by-step model, parts with buy/STL links
    build.html shows only each step's parts from build/plotter.glb (made from
    cad/plotter-assembly.scad by tools/make-build-model.py), plus printable STLs.
2026-10-25 Build guide: realistic materials and textures, tap a part to highlight it and read about it
2026-10-25 Build guide: X belt in line with the rods, ends looped on the carriage pegs, nail idler axle
2026-10-25 docs: motor size advice (short NEMA vs direct drive)
2026-10-26 Carriage plate: pocket for the micro linear stage, plate 1 mm thicker on that face
2026-10-26 Build guide: Arduino, CNC shield and drivers drawn like Tim's photos
    Blue Uno, red shield with yellow driver sockets, blue screw terminal, blue heat sinks,
    white endstop housing, empty A slot; motor leads end on the driver plugs.
2026-10-26 Direct-drive platter: printable hub for the NEMA 17 shaft and an upright motor stand
    platter_hub: 5 mm D-bore, M3 set screw with captive nut, 40 mm glue face with a ring for the CD's 15 mm hole.
    motor_stand: holds the motor on the board by its face screws, no board hole, no steel bars.
    Notes, hardware, print settings, $101 = 8.89 and the platter height change in docs/components.md section 7.
2026-10-26 progress: Vrefs set X 1.0 / Y 1.0 / Z 0.3 V
2026-10-26 Printed parts: deeper motor_plate recess, M3 idler pulley + washers, true GT2 60T pulley, paper ring
    - motor_plate: recess 1 -> 2 mm (mp_recess) on a 1 mm pad under the motor face; outline,
    holes and print-bed face unchanged
    - pulley_m3 + idler_washer: pulley_a teeth, 3.3 bore, 0.5 mm hubs, spins on an M3 x 25 bolt
    in the bracket (replaces the cut nail)
    - big_pulley_gt2: GT2 60T (OD 37.69 measured, 60 teeth), profile from droftarts' Parametric
    Pulley; big_pulley kept
    - paper_ring: 200 mm, 1.2 mm band, 4 pockets for 6x2 magnets or tape tabs (ring_magnets)
    - no center_mark: platter top has no centre feature
    - components.md 4/5/7 updated; new parts added to PRINTED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
2026-10-27 progress: shorted X/Y drivers found, next steps at the machine
2026-10-27 progress: motors hold but don't step
2026-10-27 progress: driver triage, X works
2026-11-10 progress: 11-10 bench tests, Y and Z drivers confirmed dead, all motors and slots work
2026-11-10 progress: pen stage moves (coil pairs fixed); all motors and slots proven
2026-11-11 progress: all three axes working with new drivers
2026-11-12 progress: printed one-piece platter + cone hub idea (Tim rejected screws and glue)
2026-11-12 progress: platter height rise and PVC leg spacer idea
2026-11-12 Rod holders: 8.2 mm bore (rods were barely too tight) + rod fit gauge
    Tim: the rod holders' holes are 'just barely too small for the rods to fit in'.
2026-11-12 Printed frame prototype 1: base, two stands, platter wheel (no wood, no PVC)
    Tim: scrap the wooden board and PVC pipes, print each stand and the bottom plate.
2026-11-12 Printed frame prototype 2: dovetail stands, clamp ring, front-loading cage, Uno pegs
2026-11-12 Frame proto 2 rev: cage back stop, slide-in Uno pocket, one-piece printed platter with keyed clamp ring
2026-11-12 Pen centring: derive pen_y from the carriage chain, fix cage stop (0.4) and dovetail end (0.2)
2026-11-12 Soft pad under the paper: clamp ring hooks lengthened by pad_t
2026-11-12 Pre-print check: idler out 14 mm for 90 mm pen reach, printable gusset, set screws reachable, deeper rod holes, fit test part
2026-11-12 Bearing idler: printed spacers for a bought GT2 20T idler on the M3 bolt
2026-11-12 Idler fork: slotted bolt and nut pocket as a belt tensioner
2026-11-12 Platter hub: separate shaft collar (set screws reachable) + hex taper socket in the wheel
    The wheel's set screws sat 95 mm in from the rim, out of reach of a normal hex key.
2026-11-12 Hub: header + fit-test notes for the shaft collar; progress log
2026-11-12 Build guide V1|V2 tabs and a 3D plotter simulator
    - build.html: V1 | V2 tabs. V2 is the printed-frame machine (cad/printed-frame.scad
    assembly()) as build/plotter-v2.glb, with its own steps, parts and STL links.
    - tools/make-build-model.py: `v2` / `all` targets build the V2 model.
    - sim.html + js/sim.js: the plotter app's own controls drive a pretend GRBL
    (js/simgrbl.js: real move times, G93 inverse time, 15-block planner); the 3D
    carriage, pen and platter follow it and the pen inks the turning paper.
    - js/machine.js: uses the simulator's link when sim.html provides one.
    - tests/simgrbl.test.mjs: timing, planner and a full plot through the app's streamer.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
2026-11-12 progress: pen cable idea parked, sim set-center
2026-11-12 Print plates: 5 ready-laid-out 3MFs for a 256 mm bed (both stands nested on one plate); STLs re-exported from current CAD
2026-11-12 progress: print plates
2026-11-12 Collar takes M3x8 pan-head screws: wheel socket gets a channel for the heads
2026-11-12 Progress note: carriage plate is printed and taped
2026-11-12 Tune print fits for printing without a fit test
    Dovetail 0.25/face, collar bore +0.25, nut slot 2.8, screw holes 3.4,
    collar top lowered so the hex taper always wedges before bottoming.
2026-11-12 Engineering review of the printed frame (base untouched)
    - Stand groove: only the outer flank is undercut now; the inner side is a
    0.4 mm land and a 45 degree relief, so it prints without supports.
    Flared mouth, and 0.3 mm clearance where the foot faced the base.
    - Collar taper 19 -> 16.5 across flats, chamfered foot, height set by a new
    printed gauge instead of the shaft tip. Wheel sits 2 mm over the cage.
    - Printed washers so M3x8 screws don't bottom out in the platter motor.
    - Guide: stands slide on from the back, supports setting for the base,
    gauge steps, 1.0 V drivers, starting GRBL speeds. Sim travel 93 mm.
    - Plate 1 is now collar + gauge + washers; plates 3 and 4 re-exported.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
2026-11-13 Draw tool: draw your own design on the paper
    - New Draw button beside Text and Pattern. While it is open the pointer
    draws on the preview; Undo (also undoes Clear), Clear, Done.
    - Drawn strokes keep their place and scale: strokes.radius tells fitFrame
    not to stretch them to fill the circle; layout() clips them at its edge.
    - Light smoothing of pixel stair-steps, a tap makes a pen dab, the drawing
    is kept in this browser, and drawing again after Turn / move / Crop
    carries on from where the drawing sits.
2026-11-13 Simulate: send the drawing on screen to the 3D simulator; fix simulator start-up
    - "Simulate" link beside Download G-code opens sim.html?v=2 with the current
    drawing (strokes, colours, turn/move/crop) carried over in sessionStorage.
    - Draw tool is now in the simulator too; the plan inset fills the stage while
    drawing.
    - Fix: the Draw commit threw on sim.html (no #openDraw there), so the simulator
    never finished starting.
2026-11-13 Print plates: collar, gauge and washers move onto the clamp-ring plate
    Plate 1 is gone; its three parts sit in the empty middle of the clamp ring on
    plate 5 (now plate5_clamp_ring_and_small_parts.3mf). Parts unchanged.
2026-11-13 Print plates: ABS version of plate 5 (clamp ring 0.4 % larger in X/Y)
2026-11-13 Handoff: first assembly report (pen off centre, Uno pads, rail)
2026-11-13 Base 2: platter motor 20 mm nearer the rods and adjustable, Uno pads removed
    The stage model stacked a 14 mm slider on a 20 mm body; the real slider is
    only 10 mm proud of a 20 mm-deep stage. Corrected in the shared model
    (pen line y 3.0), so the pen sits over the platter centre in both guides.
    Base: motor cage centred 20 mm further back, motor slides +-10 mm in long
    screw slots so it can be set under the real pen tip. Roof keeps a narrow
    shaft slot and a boss channel. The 4 pads under the Uno are gone.
    New print file plate2_base_only.3mf; plate 2 rebuilt with the new base.
2026-11-14 Pen holder back plate (plate 6) and paper/pad cutting circles PDF
    pen_holder(): the flat piece with a cradle at each end from the original guide's
    pen-holder set, redrawn; neck narrowed to 13.6 mm so the printed clip (14 mm opening) fits.
    paper_and_pad_circles.pdf: 196 mm paper circle and 200 mm pad circle, with a 100 mm scale check.
2026-11-14 Calibrate: slow moves you stop (turn, pen touch, circle crossing)
    Turn test: the platter turns slowly until Stop at the mark -> $101 (exact direct-drive
    value when within 2 %). Pen heights: lower until it touches, raise clear; saved as up 0 /
    down -lift with G92 Z0 at the up height, restored after Stop. Find center: the pen draws a
    circle and crosses it; the midpoint is the center and a ruler across the circle gives $100.
    Saving $100/$101 puts the work zero back (GRBL counts steps); the pretend GRBLs model that.
2026-11-14 Safeguards against wild steps-per-unit settings
    A turn count typed where degrees were wanted saved $101 = 1607 on a platter
    that needs about 4.444, and every jog then stalled the motor at full scream.
    - js/safe.js: plausible ranges for $100 / $101, warning text, step-rate caps
    - machine.js reads $$ on connect and after a setting changes; a bad axis has
    its jogs and Plot switched off, with a line pointing to Calibrate
    - calibrate.js refuses to save a value outside the range, caps its nudges in
    motor steps per second, resets absurd values before moving, and gives the
    circle, set-center and test-drawing moves a Stop
    - tests/safe.test.mjs: 7 tests built on the real mistake
    Co-Authored-By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
2026-11-14 Handoff: carriage motor dead on the platter channel, driver swap next
2026-11-14 Calibrate: Test turn, pen height by clicks, carriage test, pen direction; auto-connect
    - The settings step is gone. Turn test gets a Test button (one full turn) with
    Back / Further to correct it.
    - Pen height: click Down to the paper, Touching lifts the pen and saves both heights.
    - Carriage test is its own step: the pen draws a line, a ruler gives $100.
    - Find center has numbered instructions.
    - The pen motor is mounted reversed: the app writes $3 bit 2 on connect (setting zFlip).
    - Connect opens the one remembered port without the browser's list.
2026-11-14 Carriage buttons say Left and Right instead of In and Out
    Left = X+ (away from the center), Right = X-, on the main panel and in Calibrate.
2026-11-14 Calibrate: nothing draws on paper any more (5 steps)
    Turn direction (quarter turn, clockwise or counterclockwise) replaces the
    mirror drawing; the Carriage test is a pen-up move over a ruler, rounded to a
    belt value; Find center uses a mark under the tip and a half turn, and works
    out the center gap too.
2026-11-14 Calibrate: Test saves the measured platter value first
    Stopping the slow turn after one circle and pressing Test without Save
    tested the old value, so the platter turned twice.
